jacky4566/Veridian-Library-KiCad/3D/ASMB-KTF0-0A306.STEP

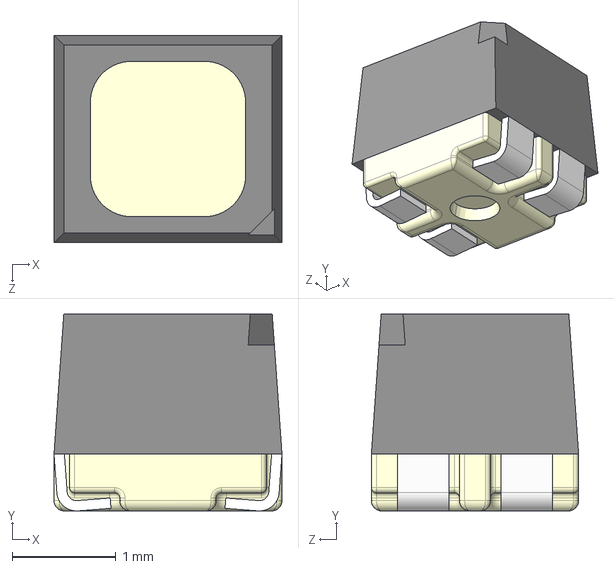
[picture p1: CAD file, 2025-11-03]
3D/ASMB-KTF0-0A306.STEP
2.20 x 1.90 x 2.00 mm
