jacky4566/Veridian-Library-KiCad/3D/2450AT18B0100001E.STEP

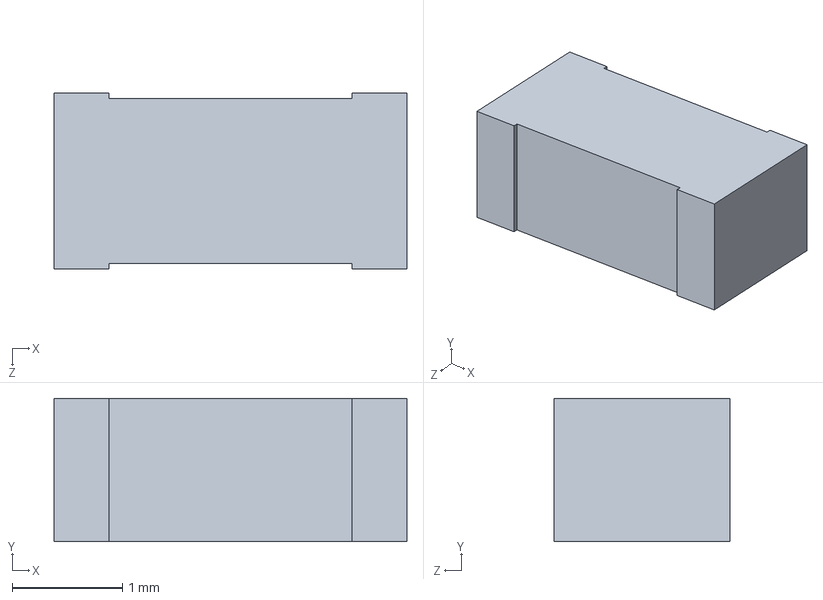
[picture p2: CAD file, 2025-12-13]
3D/2450AT18B0100001E.STEP
3.20 x 1.30 x 1.60 mm
