jacky4566/Veridian-Library-KiCad/3D/KRTB_AILMS1_20211216_geometry.STEP

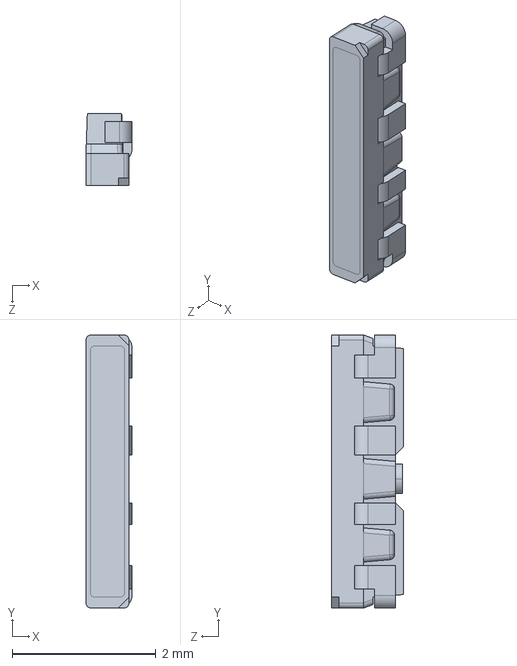
[picture p3: CAD file, 2025-12-06]
3D/KRTB_AILMS1_20211216_geometry.STEP
0.642 x 3.80 x 1.00 mm
