jacky4566/Veridian-Library-KiCad/3D/KRTB_DWLM31_32_20250507_geometry.STEP

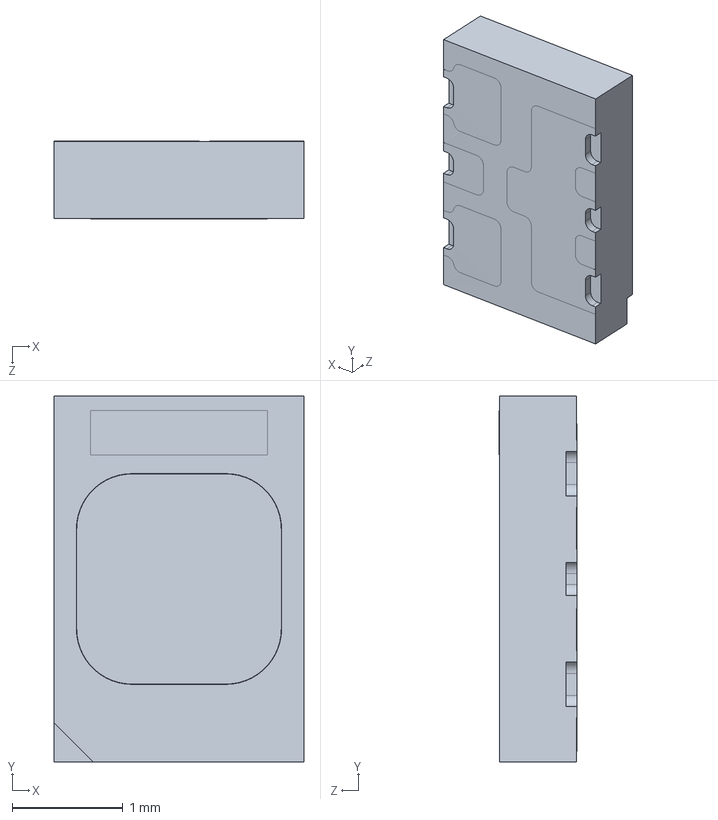
[picture p4: CAD file, 2025-11-05]
3D/KRTB_DWLM31_32_20250507_geometry.STEP
2.25 x 3.30 x 0.702 mm
