jacky4566/Veridian-Library-KiCad/3D/B3DQ3BRG.STEP

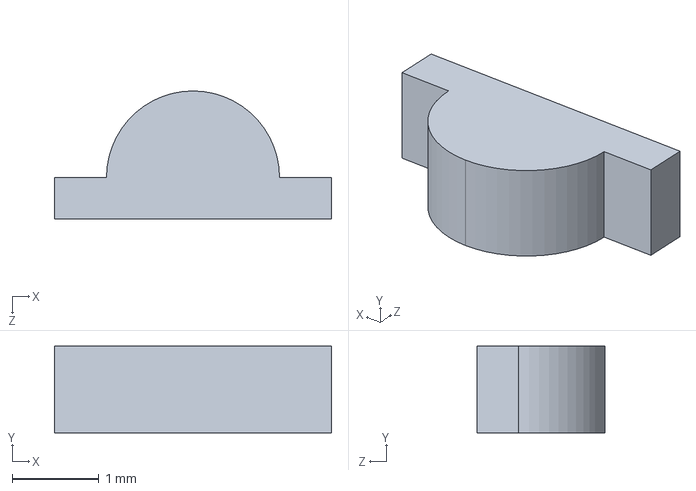
[picture p5: CAD file, 2025-10-24]
3D/B3DQ3BRG.STEP
3.20 x 1.00 x 1.48 mm
