jacky4566/Veridian-Library-KiCad/3D/B04B-JWPF-SK-R-LF--SN---3DModel-STEP-56544.STEP

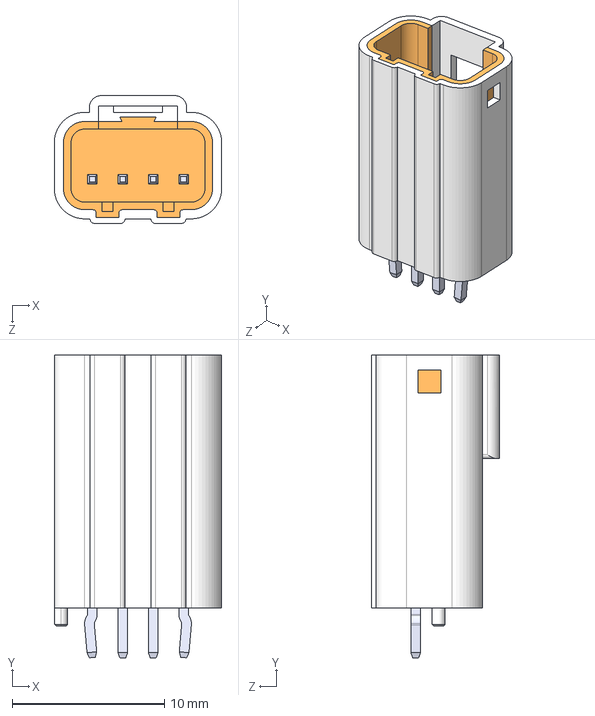
[picture p6: CAD file, 2025-05-11]
3D/B04B-JWPF-SK-R-LF--SN---3DModel-STEP-56544.STEP
11.0 x 19.9 x 8.40 mm
