jacky4566/Veridian-Library-KiCad/3D/LT8490EUKJ_PBF.step

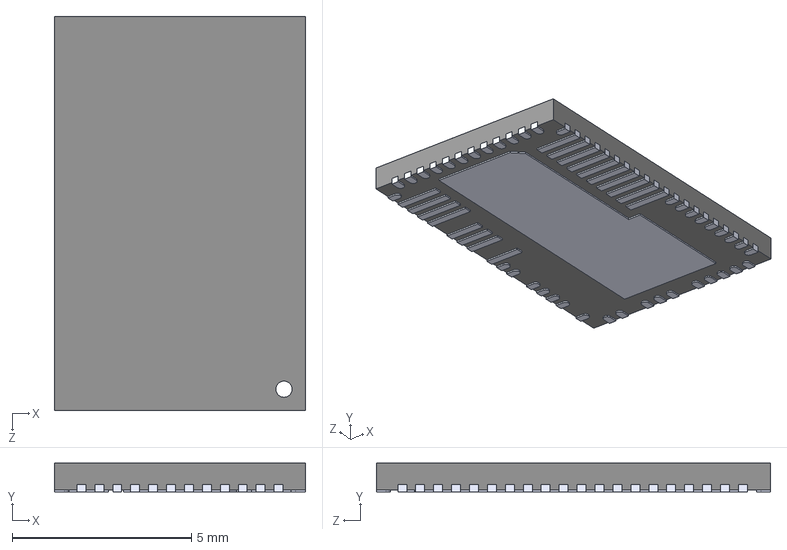
[picture p7: CAD file, 2025-05-11]
3D/LT8490EUKJ_PBF.step
7.00 x 0.8 x 11.0 mm
