jacky4566/Veridian-Library-KiCad/3D/WE-HCF_2013.step

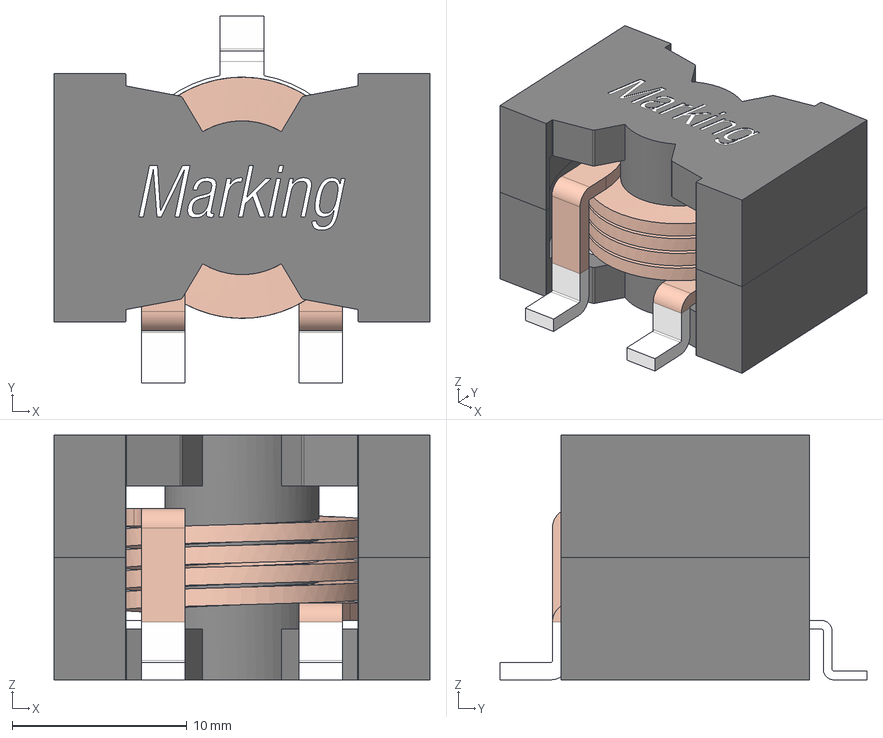
[picture p8: CAD file, 2025-05-11]
3D/WE-HCF_2013.step
21.5 x 21.0 x 14.0 mm
Core_base
Core
Clip
Spule
