jacky4566/Veridian-Library-KiCad/3D/USB4730-GF-A--3DModel-STEP-418109.STEP

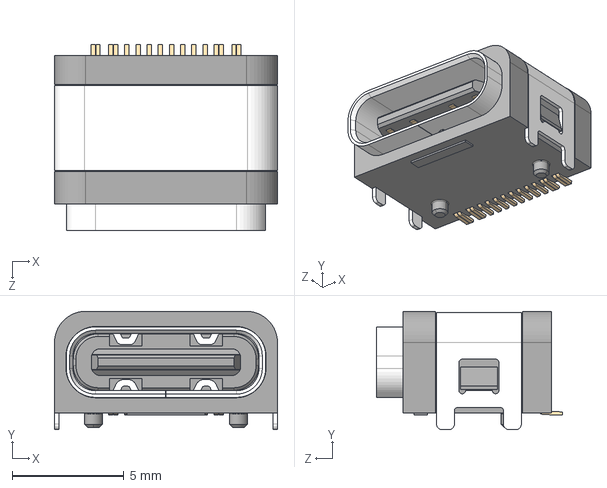
[picture p9: CAD file, 2024-06-19]
3D/USB4730-GF-A--3DModel-STEP-418109.STEP
10.0 x 5.31 x 8.36 mm
