jacky4566/Veridian-Library-KiCad/3D/FFC2A32-20-T.step

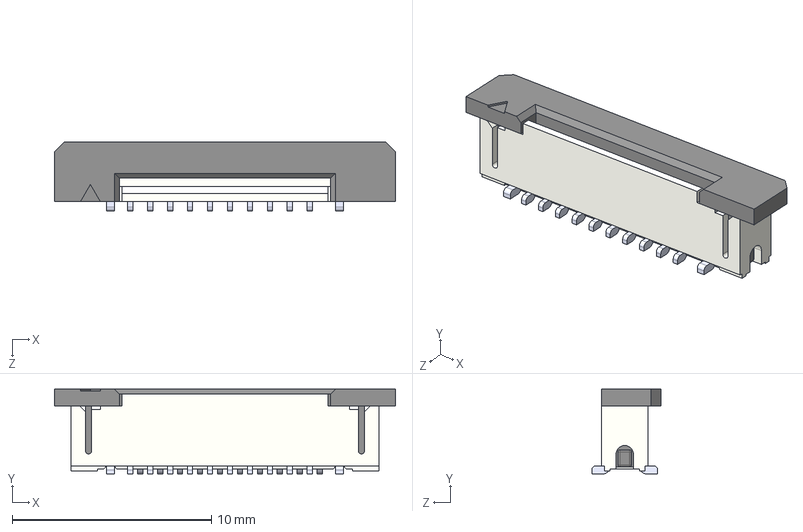
[picture p10: CAD file, 2024-02-14]
3D/FFC2A32-20-T.step
17.1 x 4.25 x 3.48 mm
FFC2A32-xxxx_20
pin x 20
