jacky4566/Veridian-Library-KiCad/3D/c-1735284-3-d-3d.stp

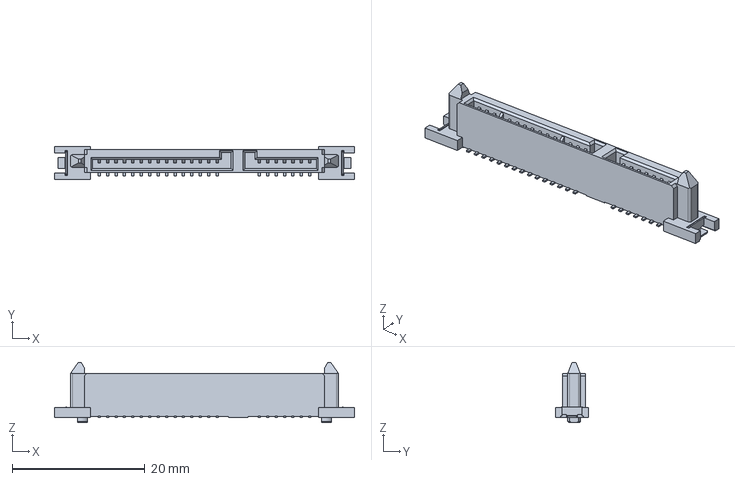
[picture p11: CAD file, 2024-01-26]
3D/c-1735284-3-d-3d.stp
45.2 x 5.00 x 9.10 mm
