jacky4566/Veridian-Library-KiCad/3D/BGT60TR13C v1.step

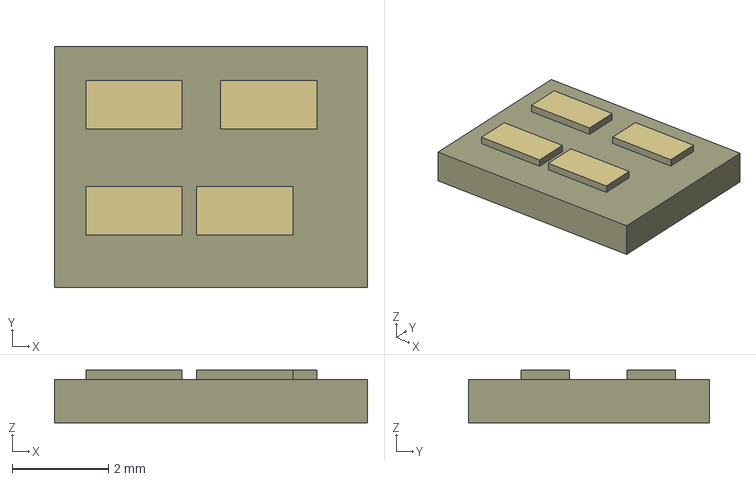
[picture p12: CAD file, 2024-01-26]
3D/BGT60TR13C v1.step
6.50 x 5.00 x 1.10 mm
