jacky4566/Veridian-Library-KiCad/3D/PEL12T-4021F-S1024--3DModel-STEP-56544.STEP

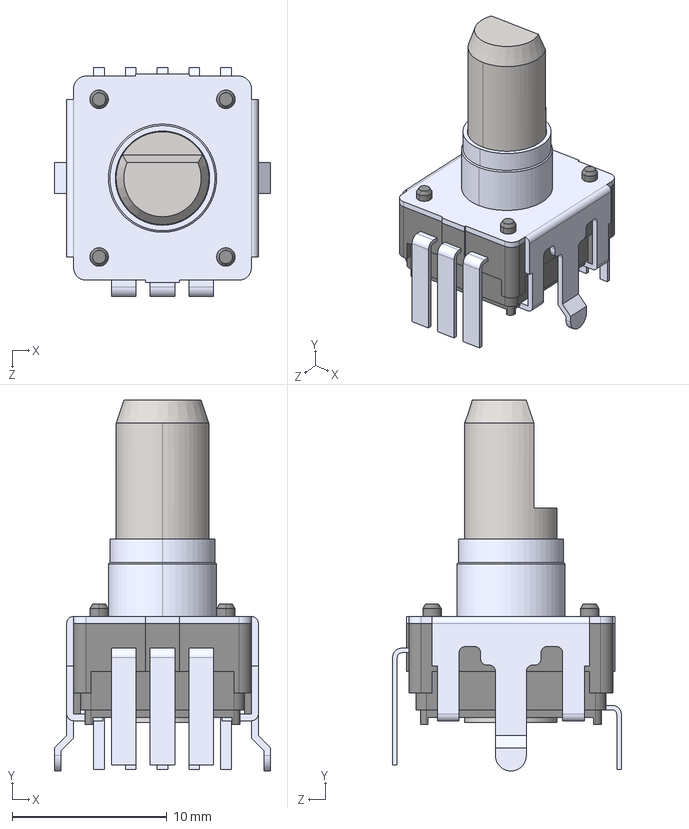
[picture p13: CAD file, 2023-02-01]
3D/PEL12T-4021F-S1024--3DModel-STEP-56544.STEP
14.0 x 24.0 x 14.8 mm
