jacky4566/Veridian-Library-KiCad/3D/SCCT30E156SRB.STEP

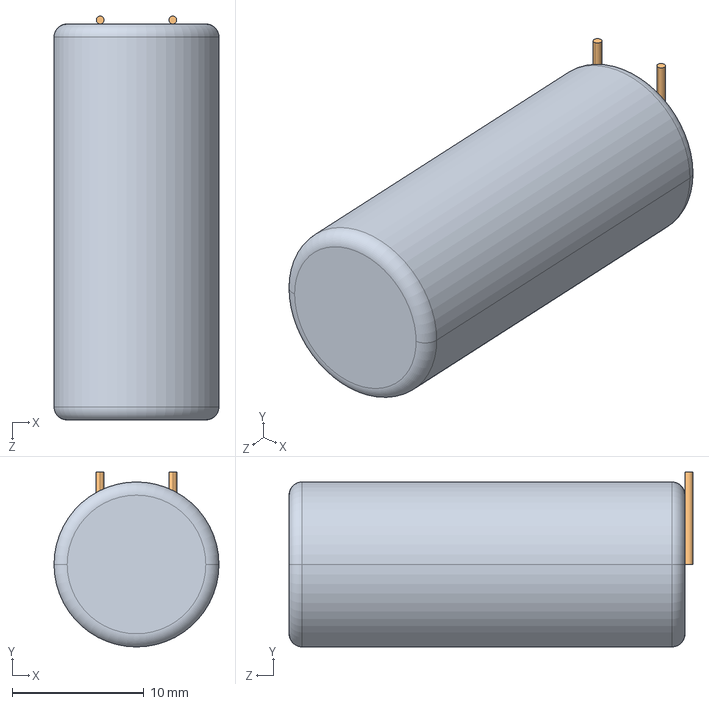
[picture p14: CAD file, 2021-11-26]
3D/SCCT30E156SRB.STEP
12.5 x 13.2 x 30.6 mm
