jacky4566/Veridian-Library-KiCad/3D/SCCT20E106SRB.STEP

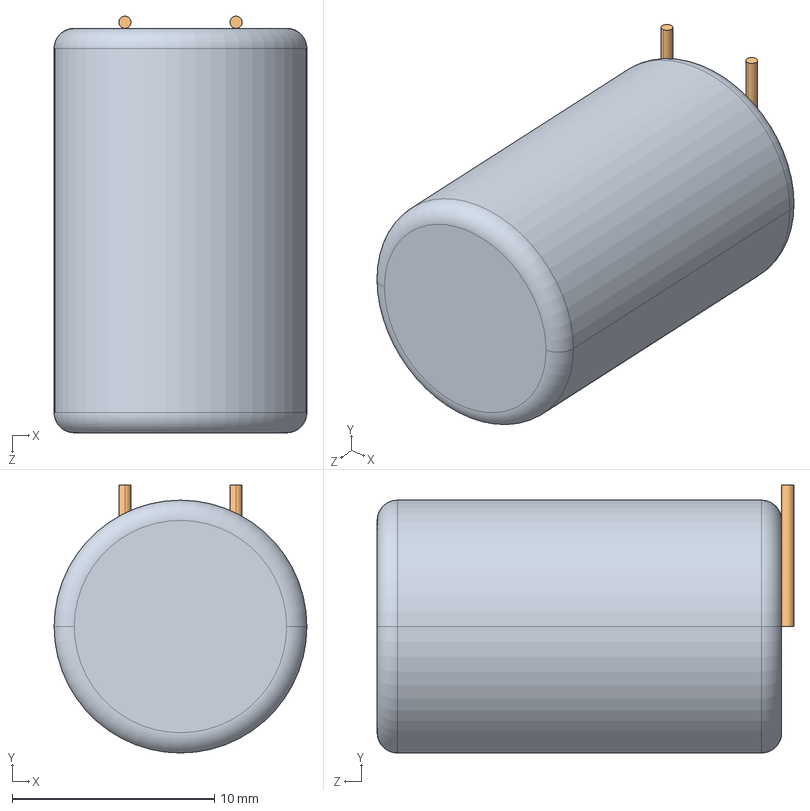
[picture p15: CAD file, 2021-11-26]
3D/SCCT20E106SRB.STEP
12.5 x 13.2 x 20.6 mm
