jacky4566/Veridian-Library-KiCad/3D/PEL12T.STEP

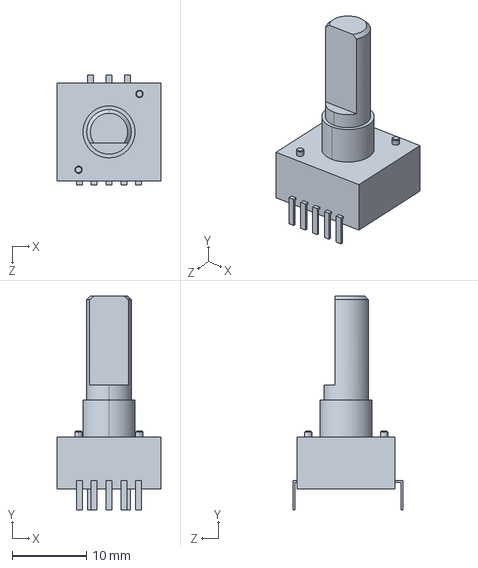
[picture p16: CAD file, 2020-11-06]
3D/PEL12T.STEP
14.0 x 28.8 x 14.8 mm
