jacky4566/Veridian-Library-KiCad/3D/5050_NeoPixel.SLDPRT

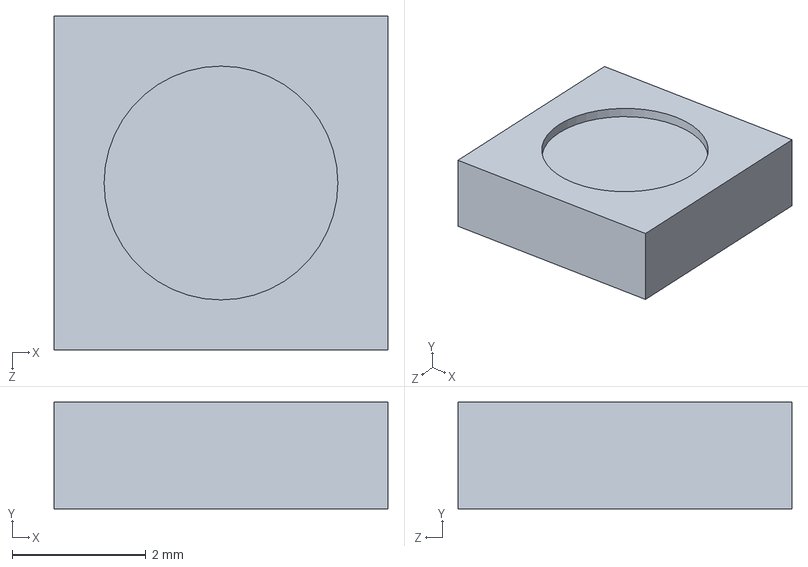
[picture p17: CAD file, 2020-11-06]
3D/5050_NeoPixel.SLDPRT
5.00 x 1.60 x 5.00 mm
