jacky4566/Veridian-Library-KiCad/3D/IN_12_3D.STEP

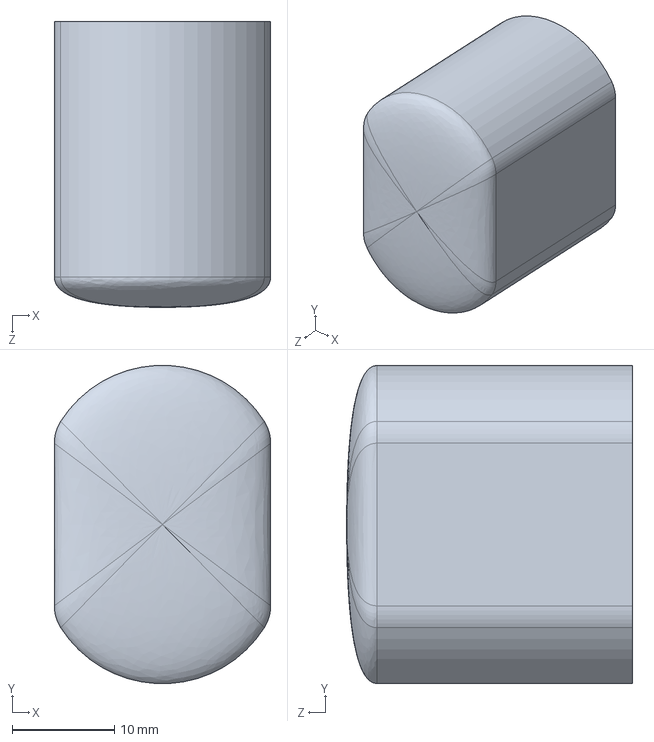
[picture p18: CAD file, 2020-11-06]
3D/IN_12_3D.STEP
21.2 x 31.2 x 28.0 mm
