jacky4566/Veridian-Library-KiCad/3D/c-2173157-3-a-3d.stp

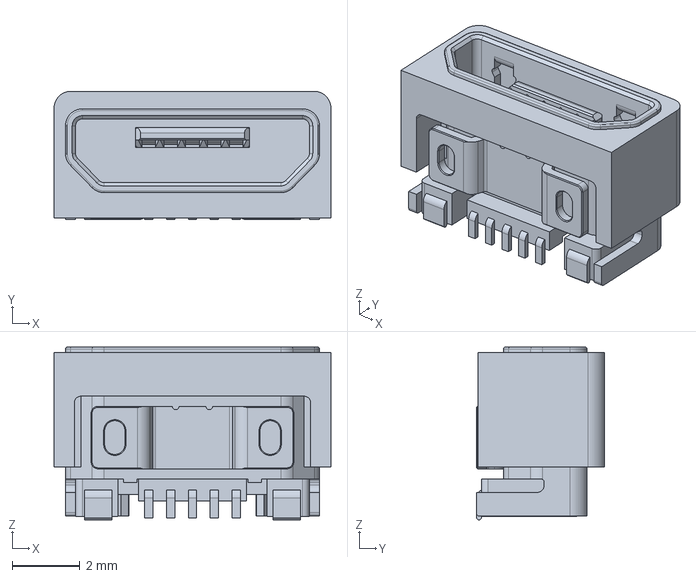
[picture p19: CAD file, 2020-11-06]
3D/c-2173157-3-a-3d.stp
8.20 x 3.80 x 5.11 mm
