jacky4566/Veridian-Library-KiCad/3D/IN_14_3D.STEP

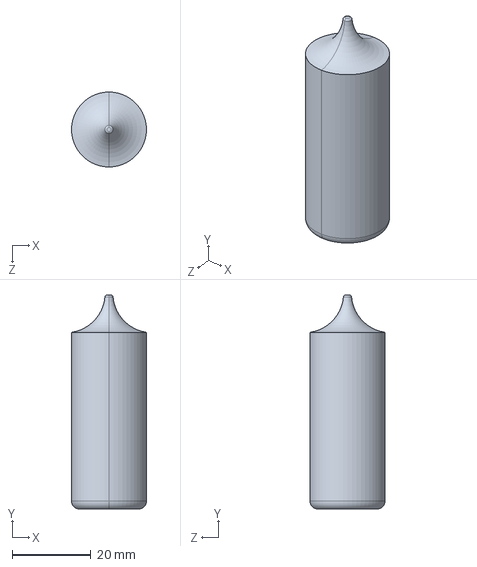
[picture p20: CAD file, 2020-11-06]
3D/IN_14_3D.STEP
19.1 x 54.5 x 19.1 mm
