jacky4566/Veridian-Library-KiCad/3D/CUI_DEVICES_UJ2-MIBV-4-SMT-TR-67.step

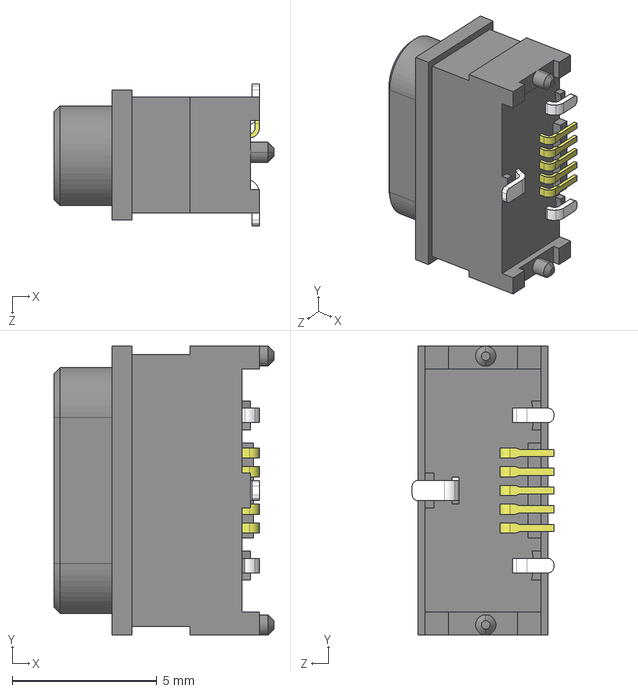
[picture p21: CAD file, 2020-11-06]
3D/CUI_DEVICES_UJ2-MIBV-4-SMT-TR-67.step
7.60 x 10.0 x 4.90 mm
