jacky4566/Veridian-Library-KiCad/3D/B06B-JWPF-SK-R.STEP

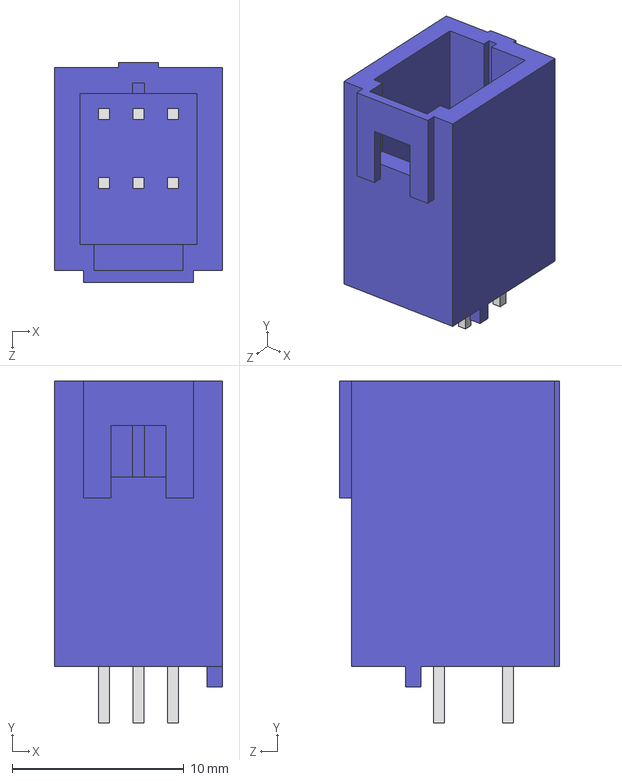
[picture p22: CAD file, 2020-11-06]
3D/B06B-JWPF-SK-R.STEP
9.80 x 19.9 x 12.8 mm
