jacky4566/Veridian-Library-KiCad/(list of files, cad)

Other CAD files:
3D/124018612112A.step
3D/7443640330_Download_STP_WE-HCF-2818_rev1.stp
3D/750312367.SLDPRT
3D/750312367.STEP
3D/IN_12_3D.SLDPRT
3D/IN_14_3D.SLDPRT
3D/IN_14_3D.STL
3D/ISO1042BDWVR.STEP
3D/s62674_201121lf.stp
