jacky4566/Veridian-Library-KiCad/(commit log)

2020-11-06 Inital Submit
    [5050_NeoPixel.SLDPRT, 750312367.SLDPRT, 750312367.STEP, B06B-JWPF-SK-R.STEP, CUI_DEVICES_UJ2-MIBV-4-SMT-TR-67.step, IN_12_3D.SLDPRT, IN_12_3D.STEP, IN_14_3D.SLDPRT]
2021-11-25 Add new Components
    [SCCT20E106SRB.STEP, SCCT30E156SRB.STEP]
2023-02-01 Add model
    [PEL12T-4021F-S1024--3DModel-STEP-56544.STEP]
2023-03-03 Migrate footprints
    [7443640330_Download_STP_WE-HCF-2818_rev1.stp]
2023-03-03 Tweak footprint for better fit
2023-04-09 Modify USB and MX23A
    [124018612112A.step]
2023-07-11 Add smaller hole pattern
2024-01-10 add BGT60C
    [BGT60TR13C v1.step]
2024-01-24 Add stuffs
    [c-1735284-3-d-3d.stp]
2024-02-14 More Stuff
    [FFC2A32-20-T.step]
2024-02-14 Create CONN_GSB1CA11101DSHR_AMP.kicad_mod
    Add vertical con
2024-02-15 Add power Mon
2024-06-19 Fix USB4730 Holes
    [USB4730-GF-A--3DModel-STEP-418109.STEP]
2024-06-19 Create long leg SOP4
2025-05-11 3D models
    [B04B-JWPF-SK-R-LF--SN---3DModel-STEP-56544.STEP, LT8490EUKJ_PBF.step, WE-HCF_2013.step]
2025-10-24 add more footprints
    [B3DQ3BRG.STEP]
2025-11-03 add LEDs
    [ASMB-KTF0-0A306.STEP]
2025-11-04 Update LED
2025-11-05 Add 3d LED
    [KRTB_DWLM31_32_20250507_geometry.STEP]
2025-12-06 Add LED
    [KRTB_AILMS1_20211216_geometry.STEP]
2025-12-13 add 3D
    [2450AT18B0100001E.STEP, ISO1042BDWVR.STEP]
2026-04-11 add esp32
